bleroy/PIX6t4Color/Media/PIX6T4_Color_Cover.png

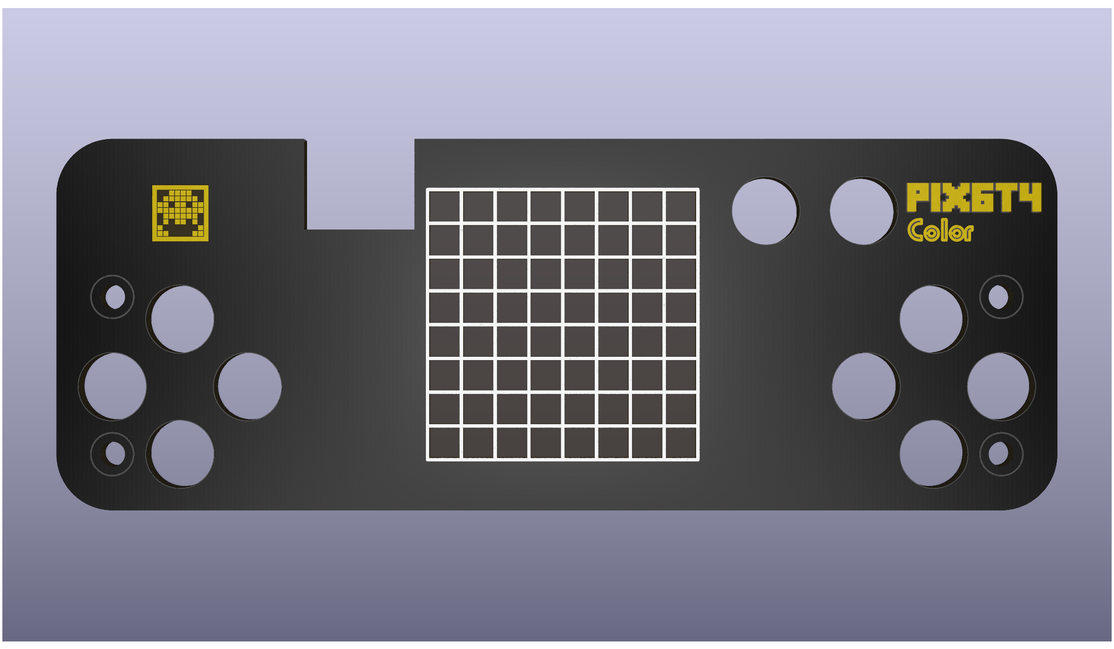
Media/PIX6T4_Color_Cover.png
