bleroy/PIX6t4Color/Media/PIX6T4_Color_PCB.png

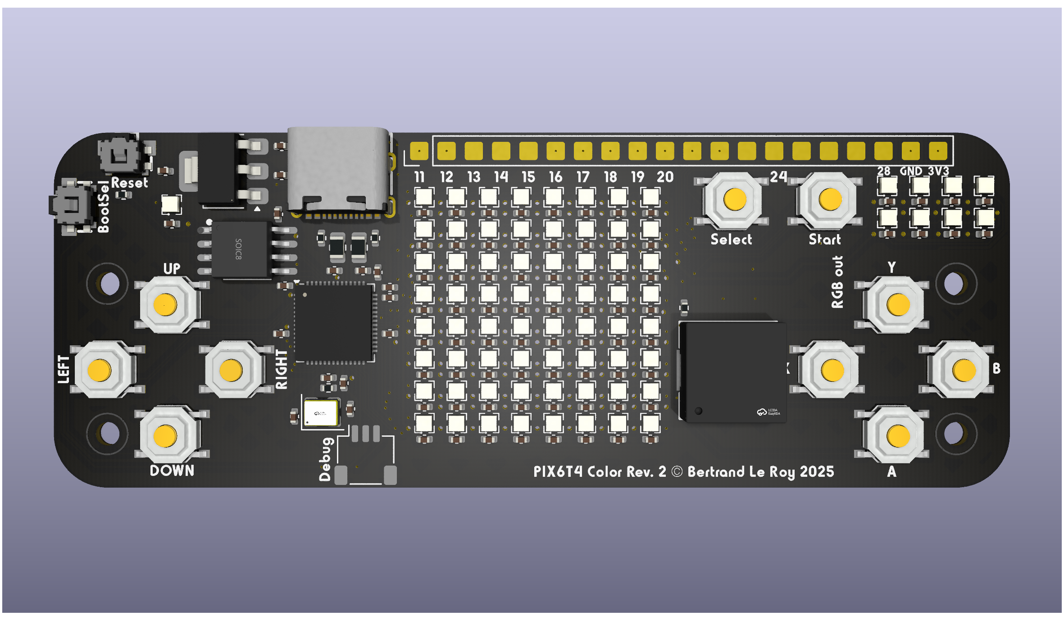
Media/PIX6T4_Color_PCB.png
