bleroy/PIX6t4Color/Media/PIX6T4_Color.png

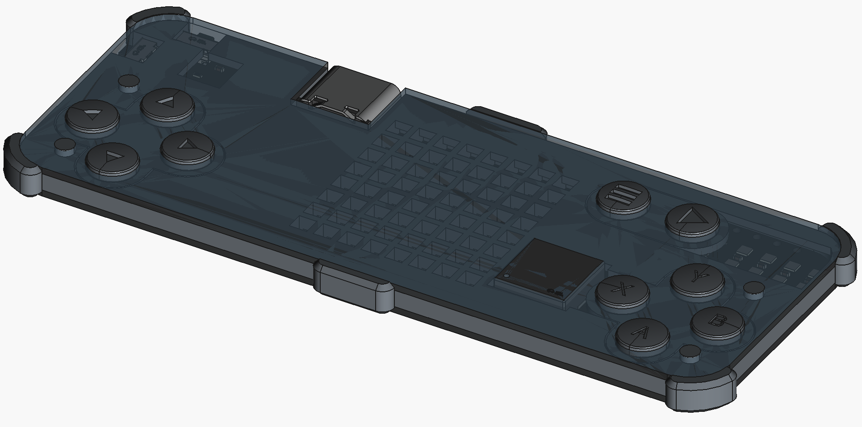
Media/PIX6T4_Color.png
