bleroy/PIX6t4Color/Printed/PIX6T4_Color-Body.3mf

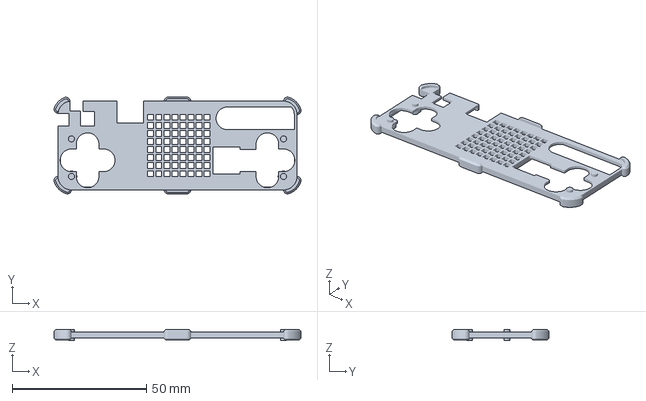
[picture p4: CAD file, 2025-09-15]
Printed/PIX6T4_Color-Body.3mf
91.9 x 36.0 x 4.00 mm
