bleroy/PIX6t4Color/Printed/PIX6T4_Color-CommandCluster.stl

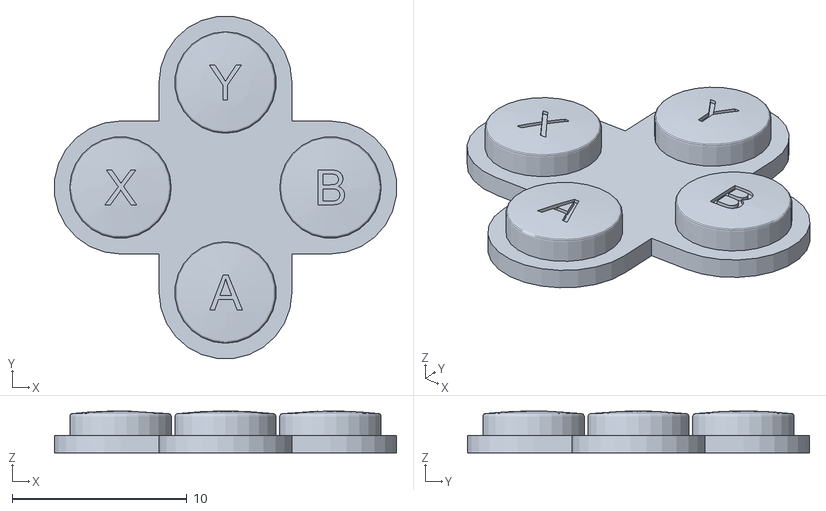
[picture p5: CAD file, 2025-08-02]
Printed/PIX6T4_Color-CommandCluster.stl
19.5 x 19.5 x 2.40
