bleroy/PIX6t4Color/Printed/PIX6T4_Color-DirCluster.stl

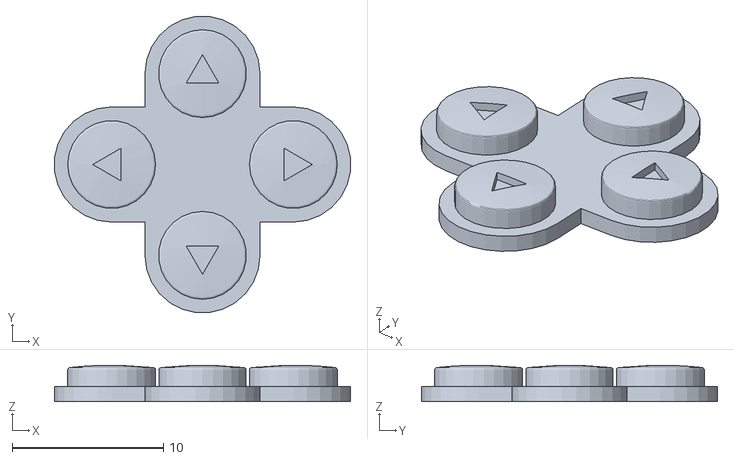
[picture p6: CAD file, 2025-08-02]
Printed/PIX6T4_Color-DirCluster.stl
19.5 x 19.5 x 2.39
