bleroy/PIX6t4Color/Printed/PIX6T4_Color-SelectStartCluster.stl

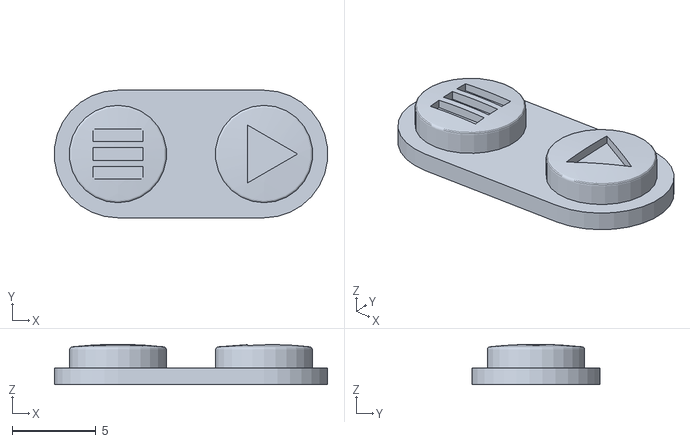
[picture p7: CAD file, 2025-08-02]
Printed/PIX6T4_Color-SelectStartCluster.stl
16.3 x 7.60 x 2.40
