bleroy/PIX6t4Color/Printed/PIX6T4_Color.FCStd

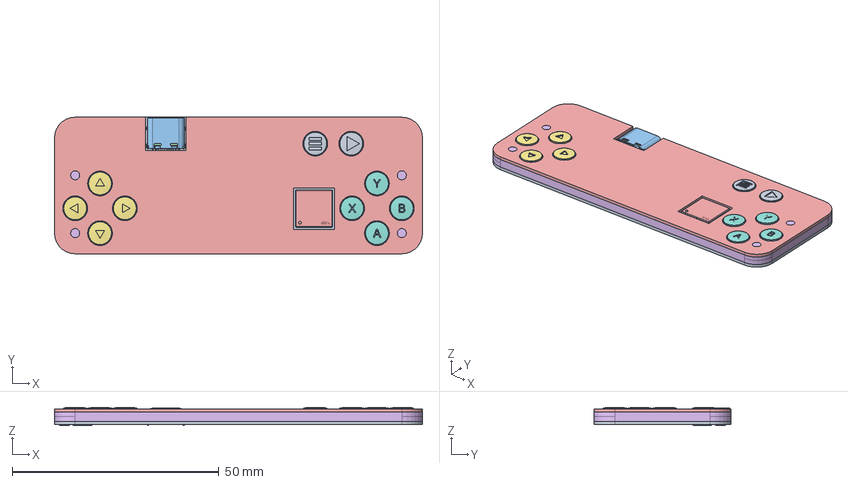
[picture p8: CAD file, 2025-07-26]
Printed/PIX6T4_Color.FCStd
88.9 x 33.0 x 4.46 mm
Pcb_e6d7
C13_C_0402_1005Metric_50b0befdca8e x 80
LED-SMD_4P-L1.4-W1.4-TL x 64
LED-SMD_4P-L1.4-W1.4-TL001 x 64
LED-SMD_4P-L1.4-W1.4-TL002 x 64
LED-SMD_4P-L1.4-W1.4-TL003 x 64
LED-SMD_4P-L1.4-W1.4-TL004 x 64
LED-SMD_4P-L1.4-W1.4-TL005 x 64
LED-SMD_4P-L1.4-W1.4-TL006 x 64
SW-SMD_4P-L5.1-W5.1-P3.70-LS6.5-TL_H1.5 x 10
SW-SMD_4P-L5.1-W5.1-P3.70-LS6.5-TL_H1.006 x 10
SW-SMD_4P-L5.1-W5.1-P3.70-LS6.5-TL_H1.007 x 10
BUZ1_BUZ-SMD_L9.0-W9.0_PKMCS0909E4000-R1_07a8d7dddef7
SW-SMD_TS24CA x 2
SW-SMD_TS24CA001 x 2
SOIC-8_L5.3-W5.3-H1.9-LS7.9-P1.27
SOIC-8_L5.3-W5.3-H1.9-LS7.9-P1.028
SOIC-8_L5.3-W5.3-H1.9-LS7.9-P1.029
SOIC-8_L5.3-W5.3-H1.9-LS7.9-P1.030
SOIC-8_L5.3-W5.3-H1.9-LS7.9-P1.031
SOIC-8_L5.3-W5.3-H1.9-LS7.9-P1.032
SOIC-8_L5.3-W5.3-H1.9-LS7.9-P1.033
SOIC-8_L5.3-W5.3-H1.9-LS7.9-P1.034
SOIC-8_L5.3-W5.3-H1.9-LS7.9-P1.035
SOIC-8_L5.3-W5.3-H1.9-LS7.9-P1.036
SOIC-8_L5.3-W5.3-H1.9-LS7.9-P1.037
SOIC-8_L5.3-W5.3-H1.9-LS7.9-P1.038
SOIC-8_L5.3-W5.3-H1.9-LS7.9-P1.039
SOIC-8_L5.3-W5.3-H1.9-LS7.9-P1.040
SOIC-8_L5.3-W5.3-H1.9-LS7.9-P1.041
SOIC-8_L5.3-W5.3-H1.9-LS7.9-P1.042
SOIC-8_L5.3-W5.3-H1.9-LS7.9-P1.043
SOIC-8_L5.3-W5.3-H1.9-LS7.9-P1.044
SOIC-8_L5.3-W5.3-H1.9-LS7.9-P1.045
SOIC-8_L5.3-W5.3-H1.9-LS7.9-P1.046
SOIC-8_L5.3-W5.3-H1.9-LS7.9-P1.047
SOIC-8_L5.3-W5.3-H1.9-LS7.9-P1.048
U4_SOT-223_3fe092ff7212
Y1_OSC-SMD_4P-L3.2-W2.5-CJ13-320001210A20_ccef43d2d814
R5_R_0402_1005Metric_084a20b118e7 x 5
R1_R_0805_2012Metric_f84fa1c03d01 x 2
U3_QFN-56-1EP_7x7mm_P0.4mm_EP3.2x3.2mm_2e8a0ed225c6
USB-C-SMD_TYPE-C-6PIN-2MD-073
USB-C-SMD_TYPE-C-6PIN-2MD-074
Pcb_83e9
DirCluster
CommandCluster
SelectStartCluster
