bleroy/PIX6t4Color/Printed/PIX6T4_Color_top.FCStd

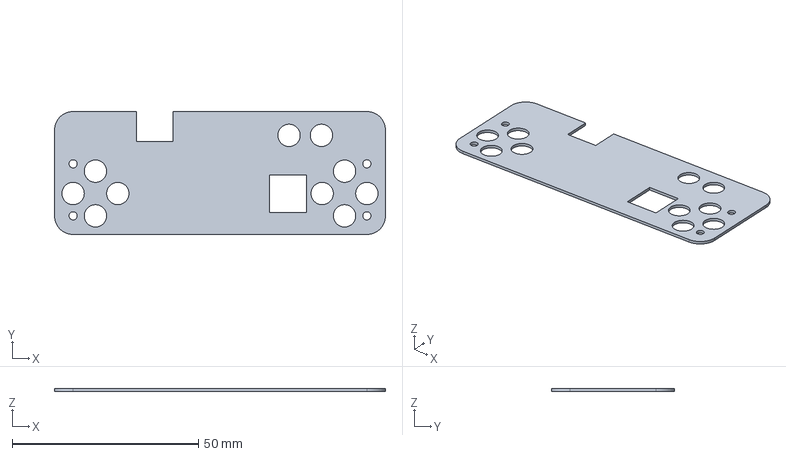
[picture p9: CAD file, 2025-07-26]
Printed/PIX6T4_Color_top.FCStd
88.9 x 33.0 x 0.8 mm
