bleroy/PIX6t4Color/(list of files, cad)

Other CAD files:
Printed/PIX6T4_Color-Body.gcode.3mf
Printed/PIX6T4_Color-Body.stl
