bleroy/PIX6t4Color/PIX6T4_Color.kicad_pcb

## KiCad design PIX6T4_Color.kicad_pcb (2025-09-11)

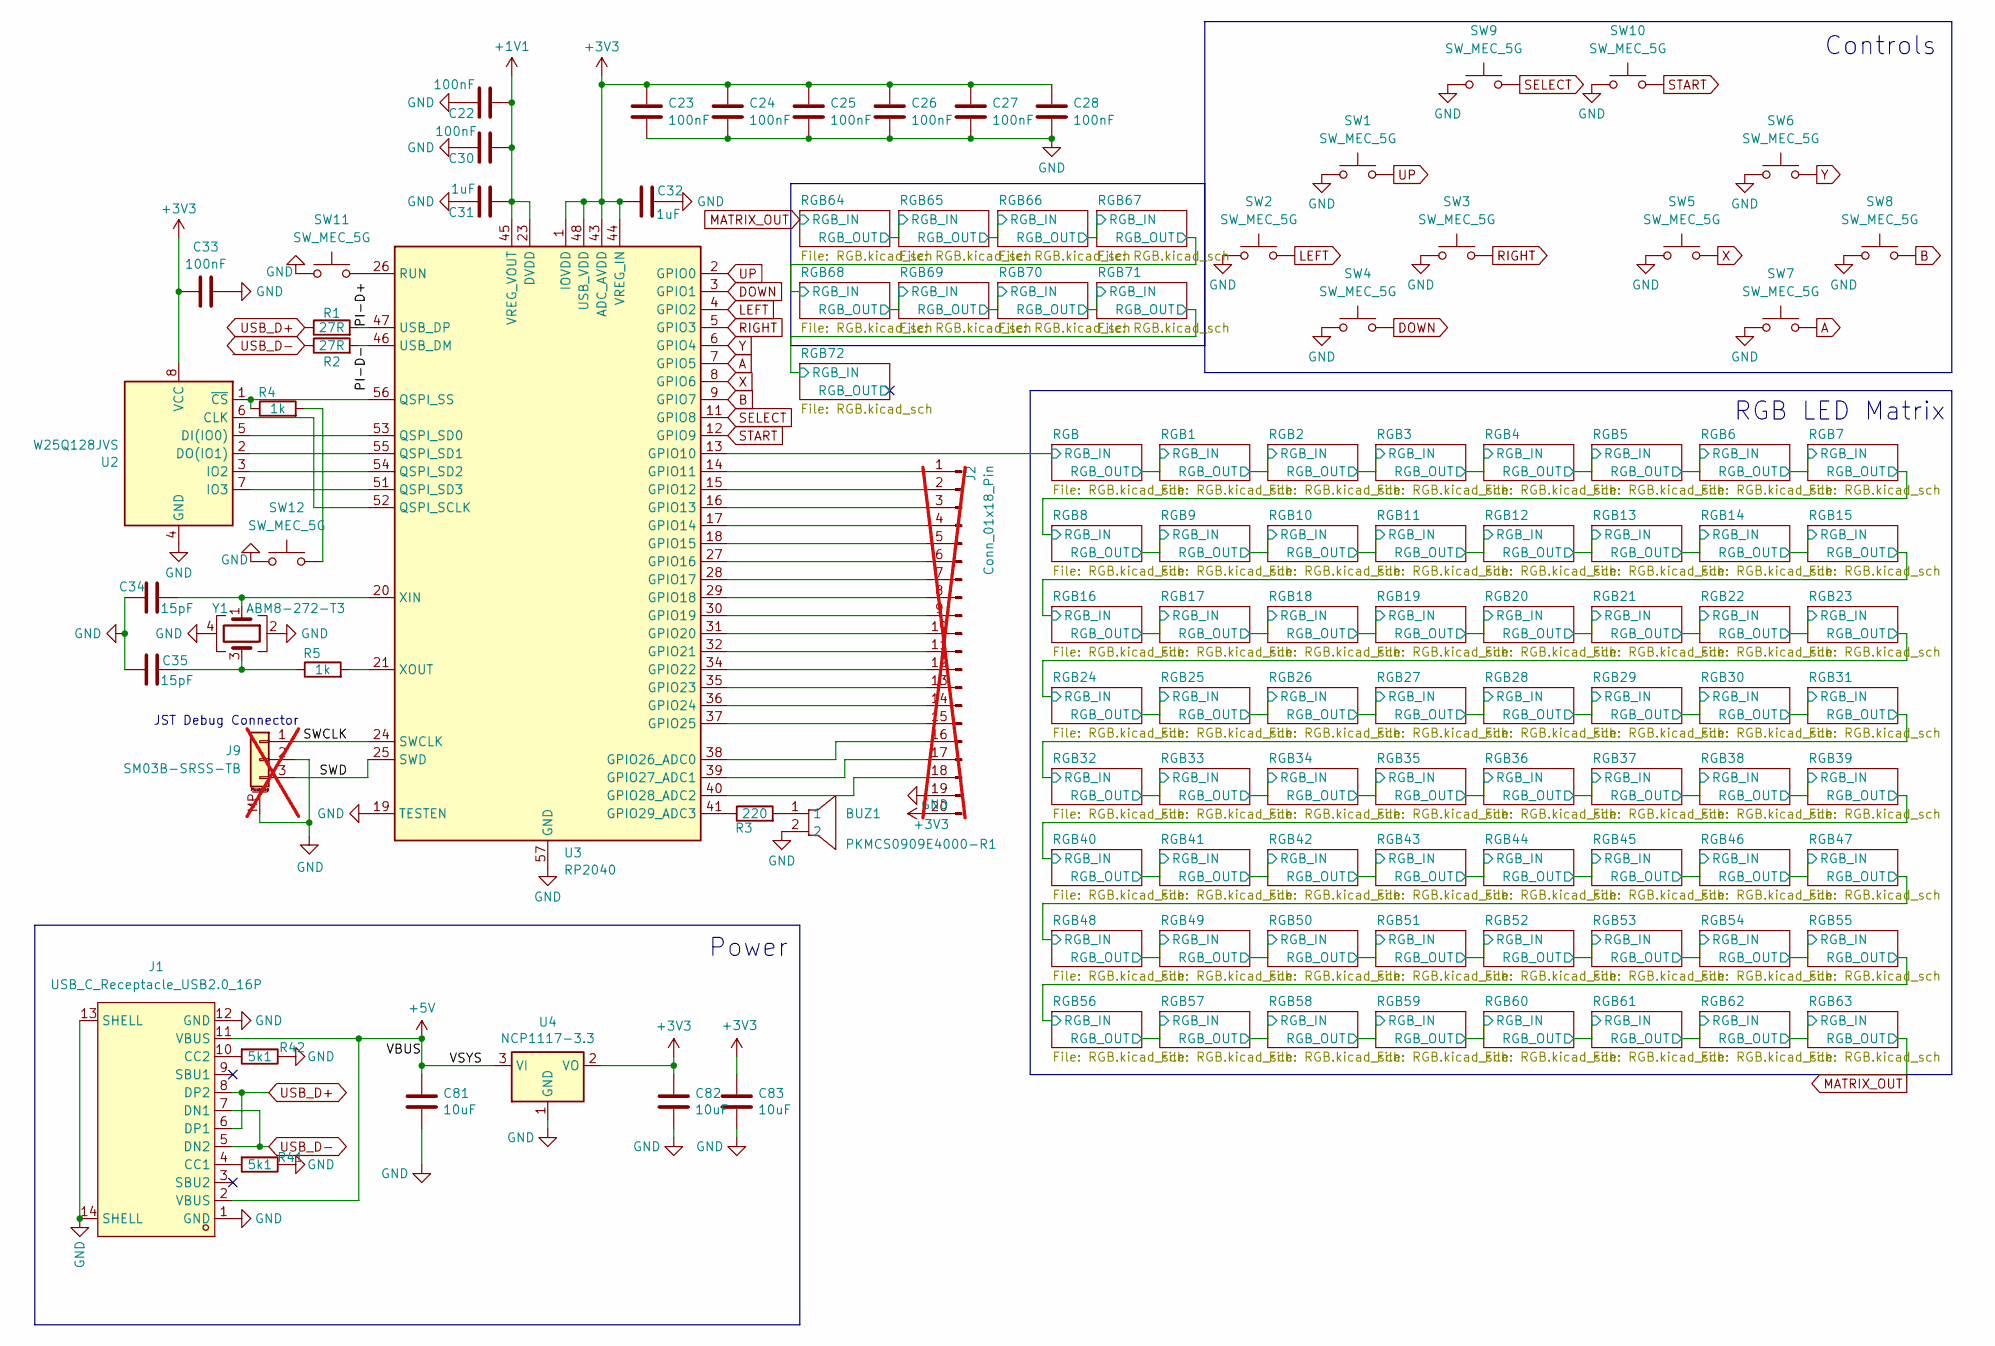
[picture p10: schematic PIX6T4_Color.kicad_sch, PIX6T4 Color]

Parts:
BUZ1: PKMCS0909E4000-R1; BUZ-SMD_L9.0-W9.0_PKMCS0909E4000-R1; JLCPCB Part # C910763
C22, C23, C24, C25, C26, C27, C28, C30, C33: 100nF; C_0402_1005Metric; JLCPCB Part # C1525
C31, C32: 1uF; C_0402_1005Metric; JLCPCB Part # C52923
C34, C35: 15pF; C_0402_1005Metric; JLCPCB Part # C1548
C81, C82, C83: 10uF; C_0402_1005Metric; JLCPCB Part # C15525
J1: USB_C_Receptacle_USB2.0_16P; USB-C-SMD_TYPE-C-6PIN-2MD-073; JLCPCB Part # C2765186
J2: Conn_01x18_Pin; PinHeader_1x20_P2.54mm_Vertical; not fitted
J9: SM03B-SRSS-TB; JST_SH_SM03B-SRSS-TB_1x03-1MP_P1.00mm_Horizontal; JLCPCB Part # C160389; not fitted
R1, R2: 27R; R_0805_2012Metric; JLCPCB Part # C17561
R3: 220; R_0402_1005Metric; JLCPCB Part # C25091
R4, R5: 1k; R_0402_1005Metric; JLCPCB Part # C11702
R41, R42: 5k1; R_0402_1005Metric; JLCPCB Part # C25905
SW1, SW2, SW3, SW4, SW5, SW6, SW7, SW8, SW9, SW10: SW_MEC_5G; SW-SMD_4P-L5.1-W5.1-P3.70-LS6.5-TL_H1.5; JLCPCB Part # C318884
SW11, SW12: SW_MEC_5G; SW-SMD_2P-TS24CA; JLCPCB Part # C393942
U2: W25Q128JVS; SOIC-8_L5.3-W5.3-P1.27-LS8.0-BL; JLCPCB Part # C97521
U3: RP2040; QFN-56-1EP_7x7mm_P0.4mm_EP3.2x3.2mm; JLCPCB Part # C2040
U4: NCP1117-3.3; SOT-223-3_TabPin2; JLCPCB Part # C6186
Y1: ABM8-272-T3; Oscillator_SMD_Abracon_ASE-4Pin_3.2x2.5mm; JLCPCB Part # C20625731

Connections:
+1V1: C22.1, C30.1, C31.1, U3.23 (DVDD), U3.45 (VREG_VOUT), U3.50 (DVDD)
+3V3: C23.1, C24.1, C25.1, C26.1, C27.1, C28.1, C32.1, C33.2, C82.1, C83.1, J2.20, U2.8 (VCC), U3.1 (IOVDD), U3.10 (IOVDD), U3.22 (IOVDD), U3.33 (IOVDD), U3.42 (IOVDD), U3.43 (ADC_AVDD), U3.44 (VREG_IN), U3.48 (USB_VDD), U3.49 (IOVDD), U4.2 (VO)
+5V: C81.1, J1.2 (VBUS), J1.11 (VBUS), U4.3 (VI); also elsewhere on the board
/PI-D+: R1.2, U3.47 (USB_DP)
/PI-D-: R2.2, U3.46 (USB_DM)
/RGB/RGB_IN: U3.13 (GPIO10); also elsewhere on the board
/SWCLK: J9.1, U3.24 (SWCLK)
/SWD: J9.3, U3.25 (SWD)
A: SW7.3 (B), SW7.4 (B), U3.7 (GPIO5)
B: SW8.3 (B), SW8.4 (B), U3.9 (GPIO7)
DOWN: SW4.3 (B), SW4.4 (B), U3.3 (GPIO1)
GND: BUZ1.2, C22.2, C23.2, C24.2, C25.2, C26.2, C27.2, C28.2, C30.2, C31.2, C32.2, C33.1, C34.1, C35.1, C81.2, C82.2, C83.2, J1.1 (GND), J1.12 (GND), J1.13 (SHELL), J1.14 (SHELL), J2.19, J9.2, J9.MP (MountPin), R41.1, R42.1, SW1.1 (A), SW1.2 (A), SW2.1 (A), SW2.2 (A), SW3.1 (A), SW3.2 (A), SW4.1 (A), SW4.2 (A), SW5.1 (A), SW5.2 (A), SW6.1 (A), SW6.2 (A), SW7.1 (A), SW7.2 (A), SW8.1 (A), SW8.2 (A), SW9.1 (A), SW9.2 (A), SW10.1 (A), SW10.2 (A), SW11.1 (A), SW11.2 (A), SW12.1 (A), SW12.2 (A), U2.4 (GND), U3.19 (TESTEN), U3.57 (GND), U4.1 (GND), Y1.2, Y1.4; also elsewhere on the board
LEFT: SW2.3 (B), SW2.4 (B), U3.4 (GPIO2)
unnamed: BUZ1.1, R3.2
unnamed: C35.2, R5.1, Y1.3
unnamed: J1.4 (CC1), R41.2
unnamed: J1.10 (CC2), R42.2
unnamed: J2.1, U3.14 (GPIO11)
unnamed: J2.2, U3.15 (GPIO12)
unnamed: J2.3, U3.16 (GPIO13)
unnamed: J2.4, U3.17 (GPIO14)
unnamed: J2.5, U3.18 (GPIO15)
unnamed: J2.6, U3.27 (GPIO16)
unnamed: J2.7, U3.28 (GPIO17)
unnamed: J2.8, U3.29 (GPIO18)
unnamed: J2.9, U3.30 (GPIO19)
unnamed: J2.10, U3.31 (GPIO20)
unnamed: J2.11, U3.32 (GPIO21)
unnamed: J2.12, U3.34 (GPIO22)
unnamed: J2.13, U3.35 (GPIO23)
unnamed: J2.14, U3.36 (GPIO24)
unnamed: J2.15, U3.37 (GPIO25)
unnamed: J2.16, U3.38 (GPIO26_ADC0)
unnamed: J2.17, U3.39 (GPIO27_ADC1)
unnamed: J2.18, U3.40 (GPIO28_ADC2)
unnamed: R4.2, SW12.3 (B), SW12.4 (B)
unnamed: U2.6 (CLK), U3.52 (QSPI_SCLK)
unnamed: U2.5 (DI(IO0)), U3.53 (QSPI_SD0)
unnamed: U2.2 (DO(IO1)), U3.55 (QSPI_SD1)
unnamed: U2.3 (IO2), U3.54 (QSPI_SD2)
unnamed: U2.7 (IO3), U3.51 (QSPI_SD3)
unnamed: R4.1, U2.1 (~CS), U3.56 (QSPI_SS)
unnamed: R3.1, U3.41 (GPIO29_ADC3)
unnamed: SW11.3 (B), SW11.4 (B), U3.26 (RUN)
unnamed: C34.2, U3.20 (XIN), Y1.1
unnamed: R5.2, U3.21 (XOUT)
RIGHT: SW3.3 (B), SW3.4 (B), U3.5 (GPIO3)
SELECT: SW9.3 (B), SW9.4 (B), U3.11 (GPIO8)
START: SW10.3 (B), SW10.4 (B), U3.12 (GPIO9)
UP: SW1.3 (B), SW1.4 (B), U3.2 (GPIO0)
USB_D+: J1.6 (DP1), J1.8 (DP2), R1.1
USB_D-: J1.5 (DN2), J1.7 (DN1), R2.1
X: SW5.3 (B), SW5.4 (B), U3.8 (GPIO6)
Y: SW6.3 (B), SW6.4 (B), U3.6 (GPIO4)

Notes on the sheet:
JST Debug Connector
Power
RGB LED Matrix
Controls

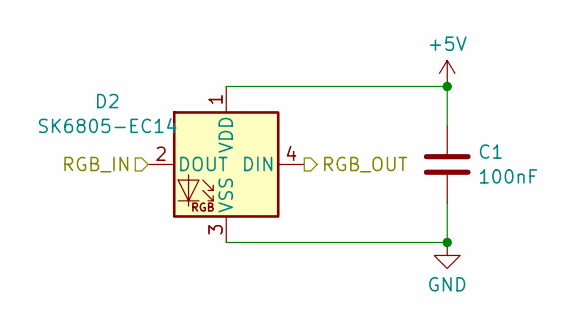
[picture p11: schematic RGB.kicad_sch]

Parts:
C1: 100nF; C_0402_1005Metric; JLCPCB Part # C1525
D2: SK6805-EC14; LED-SMD_4P-L1.4-W1.4-TL; JLCPCB Part # C2909055

Connections:
+5V: C1.1, D2.1 (VDD); also elsewhere on the board
/RGB/RGB_IN: D2.4 (DIN); also elsewhere on the board
/RGB/RGB_OUT: D2.2 (DOUT); also elsewhere on the board
GND: C1.2, D2.3 (VSS); also elsewhere on the board

Parts of its further copies:
C2, C3, C4, C5, C6, C7, C8, C9, C10, C11, C12, C13, C14, C15, C16, C17, C18, C19, C20, C21, C29, C36, C37, C38, C39, C40, C41, C42, C43, C44, C45, C46, C47, C48, C49, C50, C51, C52, C53, C54, C55, C56, C57, C58, C59, C60, C61, C62, C63, C64, C65, C66, C67, C68, C69, C70, C71, C72, C73, C74, C75, C76, C77, C78, C79, C80, C84, C85, C86, C87, C88, C89: 100nF; C_0402_1005Metric; JLCPCB Part # C1525
D1, D3, D4, D5, D6, D7, D8, D9, D10, D11, D12, D13, D14, D15, D16, D17, D18, D19, D20, D21, D22, D23, D24, D25, D26, D27, D28, D29, D30, D31, D32, D33, D34, D35, D36, D37, D38, D39, D40, D41, D42, D43, D44, D45, D46, D47, D48, D49, D50, D51, D52, D53, D54, D55, D56, D57, D58, D59, D60, D61, D62, D63, D64, D65, D66, D67, D68, D69, D70, D71, D72, D73: SK6805-EC14; LED-SMD_4P-L1.4-W1.4-TL; JLCPCB Part # C2909055

Connections of its further copies:
+5V: C2.1, C3.1, C4.1, C5.1, C6.1, C7.1, C8.1, C9.1, C10.1, C11.1, C12.1, C13.1, C14.1, C15.1, C16.1, C17.1, C18.1, C19.1, C20.1, C21.1, C29.1, C36.1, C37.1, C38.1, C39.1, C40.1, C41.1, C42.1, C43.1, C44.1, C45.1, C46.1, C47.1, C48.1, C49.1, C50.1, C51.1, C52.1, C53.1, C54.1, C55.1, C56.1, C57.1, C58.1, C59.1, C60.1, C61.1, C62.1, C63.1, C64.1, C65.1, C66.1, C67.1, C68.1, C69.1, C70.1, C71.1, C72.1, C73.1, C74.1, C75.1, C76.1, C77.1, C78.1, C79.1, C80.1, C84.1, C85.1, C86.1, C87.1, C88.1, C89.1, D1.1 (VDD), D3.1 (VDD), D4.1 (VDD), D5.1 (VDD), D6.1 (VDD), D7.1 (VDD), D8.1 (VDD), D9.1 (VDD), D10.1 (VDD), D11.1 (VDD), D12.1 (VDD), D13.1 (VDD), D14.1 (VDD), D15.1 (VDD), D16.1 (VDD), D17.1 (VDD), D18.1 (VDD), D19.1 (VDD), D20.1 (VDD), D21.1 (VDD), D22.1 (VDD), D23.1 (VDD), D24.1 (VDD), D25.1 (VDD), D26.1 (VDD), D27.1 (VDD), D28.1 (VDD), D29.1 (VDD), D30.1 (VDD), D31.1 (VDD), D32.1 (VDD), D33.1 (VDD), D34.1 (VDD), D35.1 (VDD), D36.1 (VDD), D37.1 (VDD), D38.1 (VDD), D39.1 (VDD), D40.1 (VDD), D41.1 (VDD), D42.1 (VDD), D43.1 (VDD), D44.1 (VDD), D45.1 (VDD), D46.1 (VDD), D47.1 (VDD), D48.1 (VDD), D49.1 (VDD), D50.1 (VDD), D51.1 (VDD), D52.1 (VDD), D53.1 (VDD), D54.1 (VDD), D55.1 (VDD), D56.1 (VDD), D57.1 (VDD), D58.1 (VDD), D59.1 (VDD), D60.1 (VDD), D61.1 (VDD), D62.1 (VDD), D63.1 (VDD), D64.1 (VDD), D65.1 (VDD), D66.1 (VDD), D67.1 (VDD), D68.1 (VDD), D69.1 (VDD), D70.1 (VDD), D71.1 (VDD), D72.1 (VDD), D73.1 (VDD); also elsewhere on the board
/RGB1/RGB_OUT: D1.2 (DOUT), D3.4 (DIN)
/RGB2/RGB_OUT: D3.2 (DOUT), D4.4 (DIN)
/RGB3/RGB_OUT: D4.2 (DOUT), D5.4 (DIN)
/RGB4/RGB_OUT: D5.2 (DOUT), D6.4 (DIN)
/RGB5/RGB_OUT: D6.2 (DOUT), D7.4 (DIN)
/RGB6/RGB_OUT: D7.2 (DOUT), D8.4 (DIN)
/RGB7/RGB_OUT: D8.2 (DOUT), D9.4 (DIN)
/RGB8/RGB_OUT: D9.2 (DOUT), D10.4 (DIN)
/RGB10/RGB_IN: D10.2 (DOUT), D11.4 (DIN)
/RGB10/RGB_OUT: D11.2 (DOUT), D12.4 (DIN)
/RGB11/RGB_OUT: D12.2 (DOUT), D13.4 (DIN)
/RGB12/RGB_OUT: D13.2 (DOUT), D14.4 (DIN)
/RGB13/RGB_OUT: D14.2 (DOUT), D15.4 (DIN)
/RGB14/RGB_OUT: D15.2 (DOUT), D16.4 (DIN)
/RGB15/RGB_OUT: D16.2 (DOUT), D17.4 (DIN)
/RGB16/RGB_OUT: D17.2 (DOUT), D18.4 (DIN)
/RGB17/RGB_OUT: D18.2 (DOUT), D19.4 (DIN)
/RGB18/RGB_OUT: D19.2 (DOUT), D20.4 (DIN)
/RGB19/RGB_OUT: D20.2 (DOUT), D21.4 (DIN)
/RGB20/RGB_OUT: D21.2 (DOUT), D22.4 (DIN)
/RGB21/RGB_OUT: D22.2 (DOUT), D23.4 (DIN)
/RGB22/RGB_OUT: D23.2 (DOUT), D24.4 (DIN)
/RGB23/RGB_OUT: D24.2 (DOUT), D25.4 (DIN)
/RGB24/RGB_OUT: D25.2 (DOUT), D26.4 (DIN)
/RGB25/RGB_OUT: D26.2 (DOUT), D27.4 (DIN)
/RGB26/RGB_OUT: D27.2 (DOUT), D28.4 (DIN)
/RGB27/RGB_OUT: D28.2 (DOUT), D29.4 (DIN)
/RGB28/RGB_OUT: D29.2 (DOUT), D30.4 (DIN)
/RGB29/RGB_OUT: D30.2 (DOUT), D31.4 (DIN)
/RGB30/RGB_OUT: D31.2 (DOUT), D32.4 (DIN)
/RGB31/RGB_OUT: D32.2 (DOUT), D33.4 (DIN)
/RGB32/RGB_OUT: D33.2 (DOUT), D34.4 (DIN)
/RGB33/RGB_OUT: D34.2 (DOUT), D35.4 (DIN)
/RGB34/RGB_OUT: D35.2 (DOUT), D36.4 (DIN)
/RGB35/RGB_OUT: D36.2 (DOUT), D37.4 (DIN)
/RGB36/RGB_OUT: D37.2 (DOUT), D38.4 (DIN)
/RGB37/RGB_OUT: D38.2 (DOUT), D39.4 (DIN)
/RGB38/RGB_OUT: D39.2 (DOUT), D40.4 (DIN)
/RGB39/RGB_OUT: D40.2 (DOUT), D41.4 (DIN)
/RGB40/RGB_OUT: D41.2 (DOUT), D42.4 (DIN)
/RGB41/RGB_OUT: D42.2 (DOUT), D43.4 (DIN)
/RGB42/RGB_OUT: D43.2 (DOUT), D44.4 (DIN)
/RGB43/RGB_OUT: D44.2 (DOUT), D45.4 (DIN)
/RGB44/RGB_OUT: D45.2 (DOUT), D46.4 (DIN)
/RGB45/RGB_OUT: D46.2 (DOUT), D47.4 (DIN)
/RGB46/RGB_OUT: D47.2 (DOUT), D48.4 (DIN)
/RGB47/RGB_OUT: D48.2 (DOUT), D49.4 (DIN)
/RGB48/RGB_OUT: D49.2 (DOUT), D50.4 (DIN)
/RGB49/RGB_OUT: D50.2 (DOUT), D51.4 (DIN)
/RGB50/RGB_OUT: D51.2 (DOUT), D52.4 (DIN)
/RGB51/RGB_OUT: D52.2 (DOUT), D53.4 (DIN)
/RGB52/RGB_OUT: D53.2 (DOUT), D54.4 (DIN)
/RGB53/RGB_OUT: D54.2 (DOUT), D55.4 (DIN)
/RGB54/RGB_OUT: D55.2 (DOUT), D56.4 (DIN)
/RGB55/RGB_OUT: D56.2 (DOUT), D57.4 (DIN)
/RGB56/RGB_OUT: D57.2 (DOUT), D58.4 (DIN)
/RGB57/RGB_OUT: D58.2 (DOUT), D59.4 (DIN)
/RGB58/RGB_OUT: D59.2 (DOUT), D60.4 (DIN)
/RGB59/RGB_OUT: D60.2 (DOUT), D61.4 (DIN)
/RGB60/RGB_OUT: D61.2 (DOUT), D62.4 (DIN)
/RGB61/RGB_OUT: D62.2 (DOUT), D63.4 (DIN)
/RGB62/RGB_OUT: D63.2 (DOUT), D64.4 (DIN)
/RGB64/RGB_OUT: D65.2 (DOUT), D66.4 (DIN)
/RGB65/RGB_OUT: D66.2 (DOUT), D67.4 (DIN)
/RGB66/RGB_OUT: D67.2 (DOUT), D68.4 (DIN)
/RGB67/RGB_OUT: D68.2 (DOUT), D69.4 (DIN)
/RGB68/RGB_OUT: D69.2 (DOUT), D70.4 (DIN)
/RGB69/RGB_OUT: D70.2 (DOUT), D71.4 (DIN)
/RGB70/RGB_OUT: D71.2 (DOUT), D72.4 (DIN)
/RGB71/RGB_OUT: D72.2 (DOUT), D73.4 (DIN)
/RGB72/RGB_OUT: D73.2 (DOUT)
/RGB/RGB_OUT: D1.4 (DIN); also elsewhere on the board
GND: C2.2, C3.2, C4.2, C5.2, C6.2, C7.2, C8.2, C9.2, C10.2, C11.2, C12.2, C13.2, C14.2, C15.2, C16.2, C17.2, C18.2, C19.2, C20.2, C21.2, C29.2, C36.2, C37.2, C38.2, C39.2, C40.2, C41.2, C42.2, C43.2, C44.2, C45.2, C46.2, C47.2, C48.2, C49.2, C50.2, C51.2, C52.2, C53.2, C54.2, C55.2, C56.2, C57.2, C58.2, C59.2, C60.2, C61.2, C62.2, C63.2, C64.2, C65.2, C66.2, C67.2, C68.2, C69.2, C70.2, C71.2, C72.2, C73.2, C74.2, C75.2, C76.2, C77.2, C78.2, C79.2, C80.2, C84.2, C85.2, C86.2, C87.2, C88.2, C89.2, D1.3 (VSS), D3.3 (VSS), D4.3 (VSS), D5.3 (VSS), D6.3 (VSS), D7.3 (VSS), D8.3 (VSS), D9.3 (VSS), D10.3 (VSS), D11.3 (VSS), D12.3 (VSS), D13.3 (VSS), D14.3 (VSS), D15.3 (VSS), D16.3 (VSS), D17.3 (VSS), D18.3 (VSS), D19.3 (VSS), D20.3 (VSS), D21.3 (VSS), D22.3 (VSS), D23.3 (VSS), D24.3 (VSS), D25.3 (VSS), D26.3 (VSS), D27.3 (VSS), D28.3 (VSS), D29.3 (VSS), D30.3 (VSS), D31.3 (VSS), D32.3 (VSS), D33.3 (VSS), D34.3 (VSS), D35.3 (VSS), D36.3 (VSS), D37.3 (VSS), D38.3 (VSS), D39.3 (VSS), D40.3 (VSS), D41.3 (VSS), D42.3 (VSS), D43.3 (VSS), D44.3 (VSS), D45.3 (VSS), D46.3 (VSS), D47.3 (VSS), D48.3 (VSS), D49.3 (VSS), D50.3 (VSS), D51.3 (VSS), D52.3 (VSS), D53.3 (VSS), D54.3 (VSS), D55.3 (VSS), D56.3 (VSS), D57.3 (VSS), D58.3 (VSS), D59.3 (VSS), D60.3 (VSS), D61.3 (VSS), D62.3 (VSS), D63.3 (VSS), D64.3 (VSS), D65.3 (VSS), D66.3 (VSS), D67.3 (VSS), D68.3 (VSS), D69.3 (VSS), D70.3 (VSS), D71.3 (VSS), D72.3 (VSS), D73.3 (VSS); also elsewhere on the board
MATRIX_OUT: D64.2 (DOUT), D65.4 (DIN)

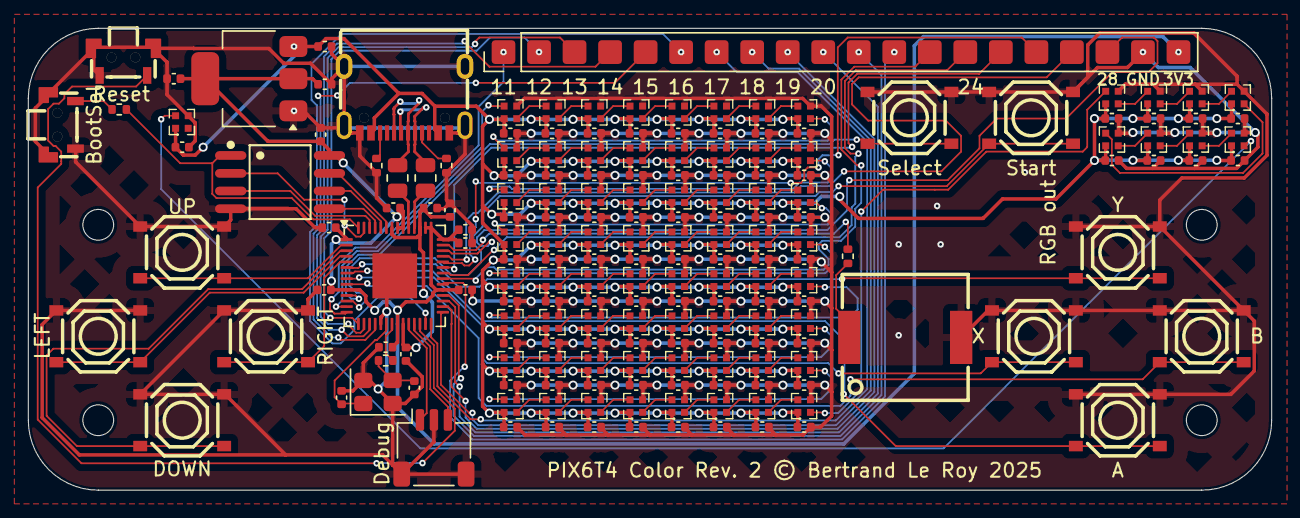
[picture p12: board PIX6T4_Color.kicad_pcb from above]

Board: 2 copper layers, 88.9 x 33.0 mm, 189 parts (0 on the bottom side), 126 nets.
