bleroy/PIX6t4Color/(commit log)

2025-07-26 Initial population
    [PIX6T4_Color-Body.3mf, PIX6T4_Color-Body.gcode.3mf, PIX6T4_Color-Body.stl, PIX6T4_Color-CommandCluster.stl, PIX6T4_Color-DirCluster.stl, PIX6T4_Color-SelectStartCluster.stl, PIX6T4_Color.FCStd, PIX6T4_Color.kicad_pcb]
2025-08-02 Rev. 2
    [PIX6T4_Color-Body.3mf, PIX6T4_Color-Body.gcode.3mf, PIX6T4_Color-Body.stl, PIX6T4_Color-CommandCluster.stl, PIX6T4_Color-DirCluster.stl, PIX6T4_Color-SelectStartCluster.stl, PIX6T4_Color.kicad_pcb, PIX6T4_Color.kicad_sch]
2025-08-22 Small fixes to the printed parts
    [PIX6T4_Color-Body.3mf, PIX6T4_Color-Body.gcode.3mf, PIX6T4_Color-Body.stl]
2025-09-11 Add power / invader logo light
    [PIX6T4_Color.kicad_pcb, PIX6T4_Color.kicad_sch, PIX6T4_Color_top.kicad_pcb, RGB.kicad_sch, bom.csv, designators.csv, positions.csv]
2025-09-11 Power LED window
    PCB holders around the device
    [PIX6T4_Color-Body.stl]
2025-09-15 Smol sings
    [PIX6T4_Color-Body.3mf]
