bleroy/PIX6t4Color/(notices)

Notices in the files:
PIX6T4_Color.kicad_pcb:
PIX6T4 Color Rev. 2 © Bertrand Le Roy 2025
